GhostWrench/ttrpg9000/img/4ColorDice.png

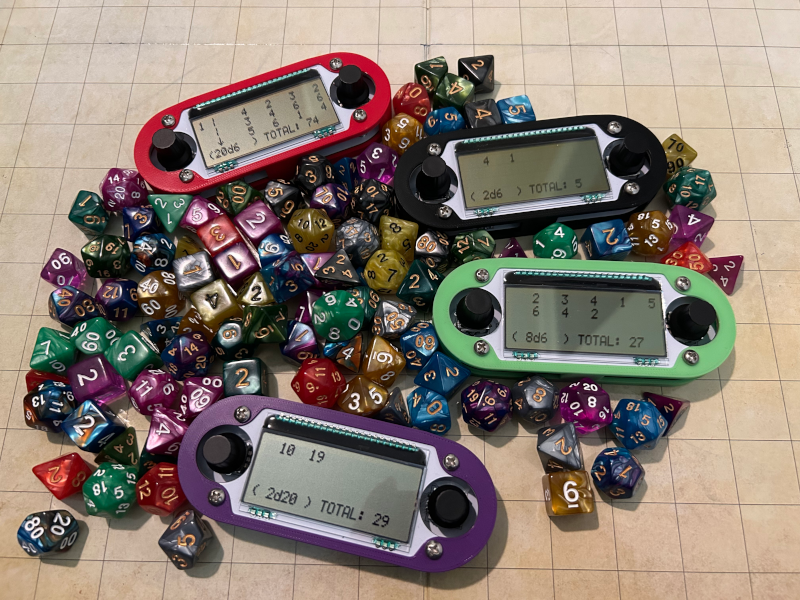
img/4ColorDice.png
