GhostWrench/ttrpg9000/case/InsertSword.FCStd

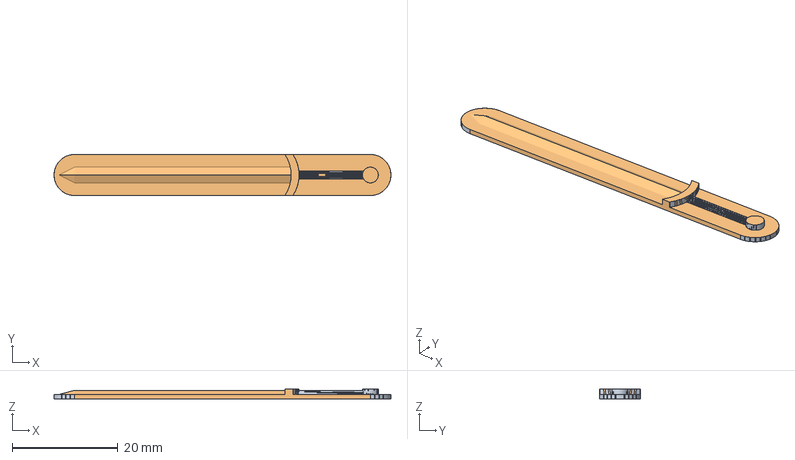
[picture p4: CAD file, 2026-09-27]
case/InsertSword.FCStd
63.8 x 7.80 x 1.80 mm
InsertSword
