GhostWrench/ttrpg9000/case/InsertCircuit.FCStd

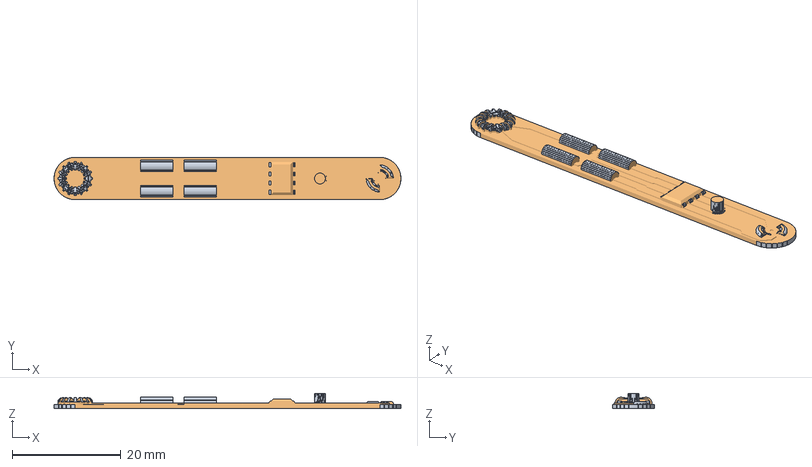
[picture p5: CAD file, 2026-09-27]
case/InsertCircuit.FCStd
63.8 x 7.80 x 2.80 mm
InsertCircuit
