GhostWrench/ttrpg9000/case/InsertRacetrack.FCStd

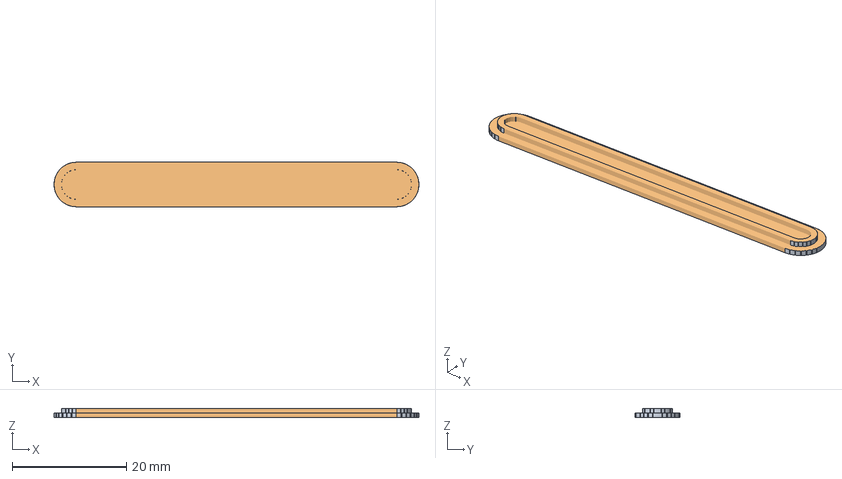
[picture p6: CAD file, 2026-09-27]
case/InsertRacetrack.FCStd
63.8 x 7.80 x 1.60 mm
InsertRacetrack
