GhostWrench/ttrpg9000/case/KnobHexagon.FCStd

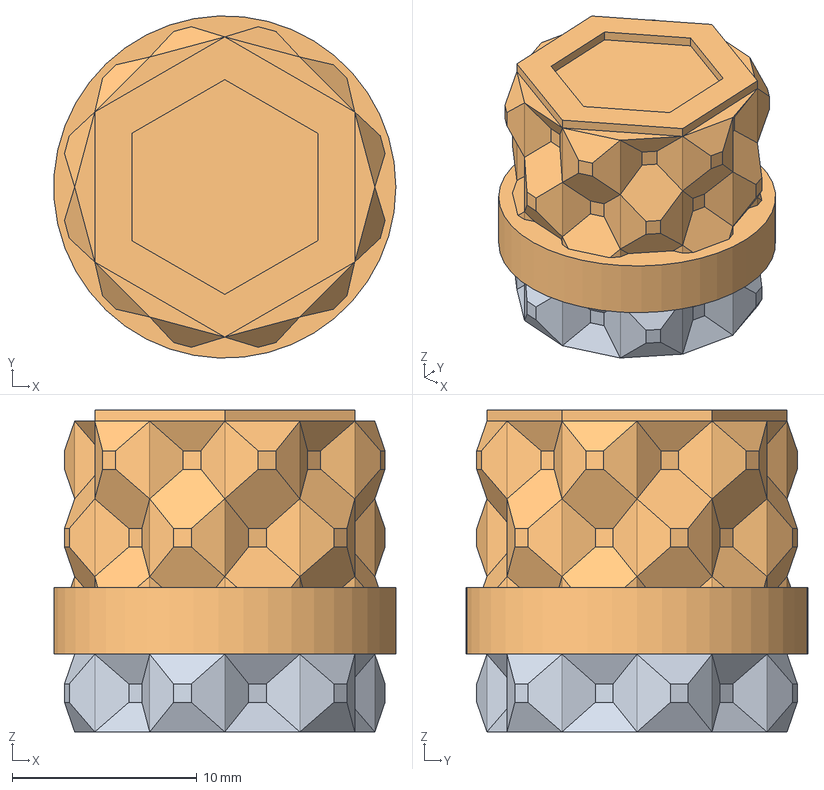
[picture p7: CAD file, 2026-09-27]
case/KnobHexagon.FCStd
18.5 x 18.5 x 17.4 mm
KnobHexagon
