GhostWrench/ttrpg9000/case/CaseMinimal.FCStd

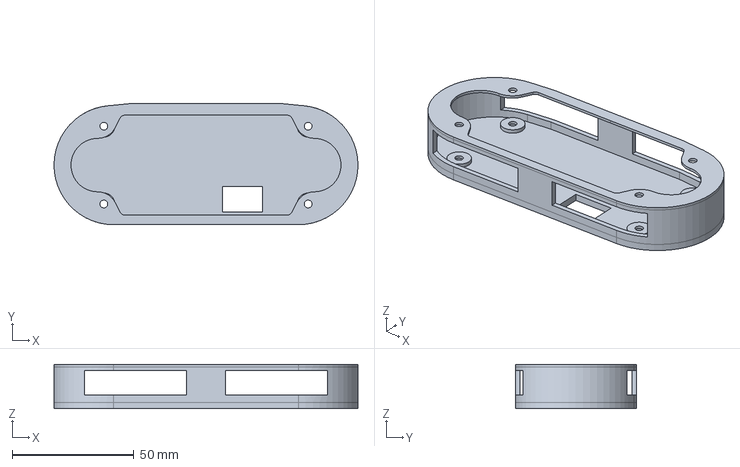
[picture p8: CAD file, 2026-09-27]
case/CaseMinimal.FCStd
125.0 x 49.9 x 18.2 mm
