GhostWrench/ttrpg9000/case/KnobD20.FCStd

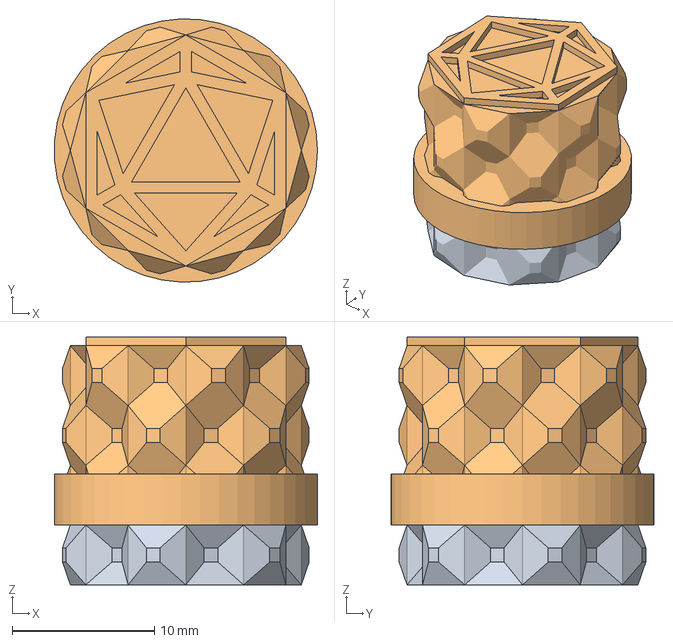
[picture p9: CAD file, 2026-09-27]
case/KnobD20.FCStd
18.5 x 18.5 x 17.4 mm
KnobD20
