GhostWrench/ttrpg9000/case/Stand.FCStd

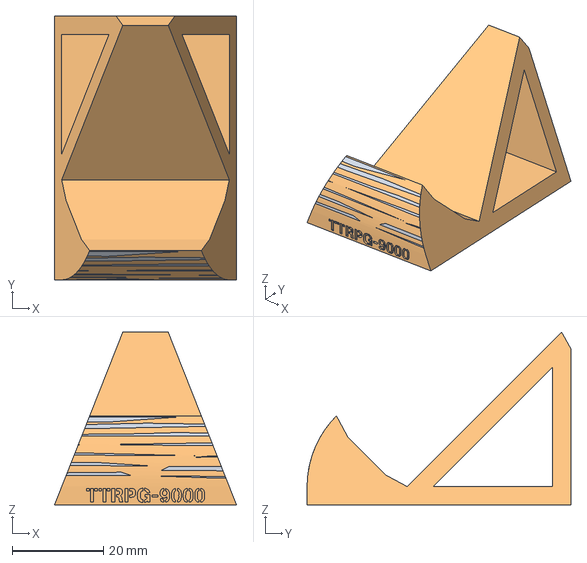
[picture p10: CAD file, 2026-09-27]
case/Stand.FCStd
40.0 x 58.0 x 37.9 mm
Stand
