GhostWrench/ttrpg9000/case/CaseFancy.FCStd

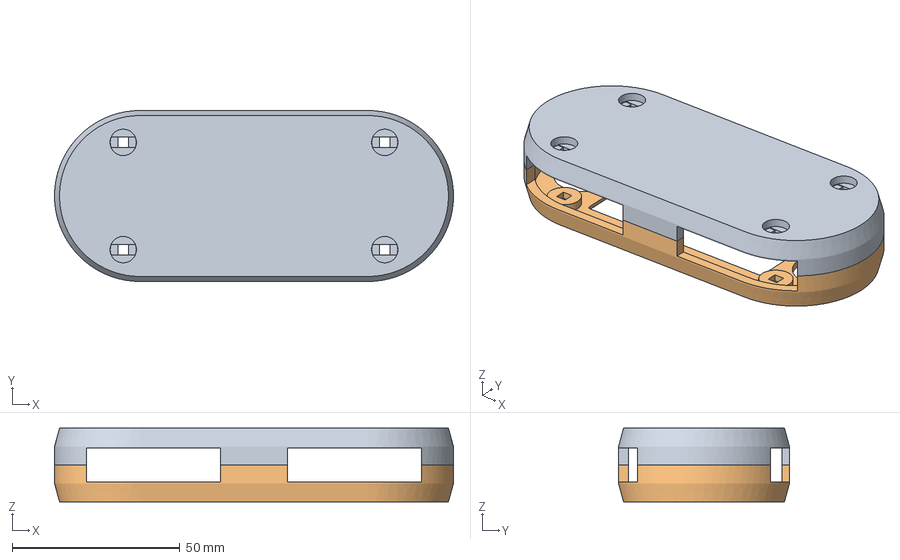
[picture p11: CAD file, 2026-09-27]
case/CaseFancy.FCStd
119.0 x 51.0 x 22.0 mm
CaseBottom
CaseTop
