GhostWrench/ttrpg9000/code/include/ui.h

/**
 * @file ui.h
 * @defgroup ttrpg9000_ui User interface module
 * @brief Home, dice selection and roll result screens.
 *
 * The UI is a small state machine driven by UIInput events which are
 * produced by the GPIO interrupt handlers when the user turns an
 * encoder or presses a button.
 */

#ifndef TTRPG9000_UI_H
#define TTRPG9000_UI_H

/**
 * @ingroup ttrpg9000_ui
 * @brief User input events reported to the UI.
 */
typedef enum __attribute__((packed)) {
    /** Left encoder rotated clockwise. */
    ENL_CW,
    /** Left encoder rotated counter clockwise. */
    ENL_CCW,
    /** Left pushbutton pressed. */
    PBL_PRESS,
    /** Right encoder rotated clockwise. */
    ENR_CW,
    /** Right encoder rotated counter clockwise. */
    ENR_CCW,
    /** Right pushbutton pressed. */
    PBR_PRESS,
} UIInput;

/**
 * @ingroup ttrpg9000_ui
 * @brief Show the home (title) screen.
 *
 * Resets the UI to the home screen and displays the title. The dice
 * selection defaults depend on the active game mode.
 */
void ui_home(void);

/**
 * @ingroup ttrpg9000_ui
 * @brief Handle a user input event.
 *
 * Interprets the input in the context of the currently displayed
 * screen and updates the display and UI state accordingly.
 *
 * @param input The input event to process.
 */
void ui_manager(UIInput input);

#endif // TTRPG9000_UI_H
