GhostWrench/ttrpg9000/(commit log)

2024-04-13 Add initial schematic
    [ttrpg9000.kicad_pcb, ttrpg9000.kicad_sch]
2024-04-13 Add KiCAD .gitignore file
2024-04-13 Second pass of schematic, start layout
    [ttrpg9000.kicad_pcb, ttrpg9000.kicad_sch]
2024-04-13 Clean up board layout
    [2024-04-13T023628.csv, ttrpg9000.kicad_pcb, ttrpg9000.kicad_sch]
2024-04-14 Finalize v0.1 board layout
    [ttrpg9000.kicad_pcb]
2024-04-14 Fix logo silk mask
    [2024-04-12T162524.csv, 2024-04-13T023628.csv, ttrpg9000.kicad_pcb]
2024-04-14 Update gerber output file
    [ttrpg9000.kicad_pcb]
2024-04-16 Move hardware designs to the 'hardware' folder
    [ttrpg9000.kicad_pcb, ttrpg9000.kicad_sch]
2024-04-16 Add RESET pull-up, mounting holes
    [ttrpg9000.kicad_pcb, ttrpg9000.kicad_sch]
2024-04-16 Add programming header to the board
    [ttrpg9000.kicad_pcb, ttrpg9000.kicad_sch]
2024-04-16 Add silkscreen info to board
    [ttrpg9000.kicad_pcb, ttrpg9000.kicad_sch]
2024-04-17 Add mounting holes to the PCB
    [ttrpg9000.kicad_pcb, ttrpg9000.kicad_sch]
2024-04-20 Fix resistor footprints
    [ttrpg9000.kicad_pcb, ttrpg9000.kicad_sch]
2024-04-23 Wire pushbuttons to ground because ATtiny2313 have pull-up pins
    [ttrpg9000.kicad_pcb, ttrpg9000.kicad_sch]
2024-04-23 Start writing the software for the board
2024-04-24 Board initialization code first pass
2024-04-25 Change regulator footprint so that it is easier to solder
    [ttrpg9000.kicad_pcb, ttrpg9000.kicad_sch]
2024-04-25 Move MCU to front of the board
    [ttrpg9000.kicad_pcb]
2024-04-25 Make battery holder smaller and move to the front, plate mounting holes
    [ttrpg9000.kicad_pcb, ttrpg9000.kicad_sch]
2024-04-25 Export v0.2 hardware design
    [ttrpg9000.kicad_pcb]
2024-04-27 Update schematic and layout for SPI connection to LCD screen
    [ttrpg9000.kicad_pcb, ttrpg9000.kicad_sch]
2024-04-27 Fix battery holder placement
    [ttrpg9000.kicad_pcb]
2024-04-27 Add compiling SPI versoin of main
2024-05-03 LCD works with SPI
2024-05-04 Fix interrupts for encoder and pushbutton input
    [main.c]
2024-05-04 Update pushbutton cap values for better debounce
    [ttrpg9000.kicad_pcb, ttrpg9000.kicad_sch]
2024-05-05 Make the board into a board sandwich
    [ttrpg9000.kicad_pcb, ttrpg9000.kicad_sch]
2024-05-05 Not sure what changed
    [ttrpg9000.kicad_pcb]
2024-05-07 Add bigger ribbon cable connectors, status leds
    [ttrpg9000.kicad_pcb, ttrpg9000.kicad_sch]
2024-05-07 Update version indicators
    [ttrpg9000.kicad_pcb, ttrpg9000.kicad_sch]
2024-05-07 Fix hole size, make LEDs more central
    [ttrpg9000.kicad_pcb, ttrpg9000.kicad_sch]
2024-05-07 Final touch-ups
    [ttrpg9000.kicad_pcb, ttrpg9000.kicad_sch]
2024-05-07 Add V-Score back into board design
    [ttrpg9000.kicad_pcb]
2024-05-16 Widen footprint, modify layout
    [ttrpg9000.kicad_pcb, ttrpg9000.kicad_sch]
2024-05-16 Make a bigger ground pad for the voltage regulator
    [ttrpg9000.kicad_pcb, ttrpg9000.kicad_sch]
2024-05-16 Update fabrication output location
    [ttrpg9000.kicad_pcb]
2024-05-19 Get encoders working
2024-05-19 Replace fancy ribbon cable connectors with soldered ribbon cable
    [ttrpg9000.kicad_pcb, ttrpg9000.kicad_sch]
2024-05-20 Add basic outline for UI, not currently working right
2024-05-20 Fix screen navigation issue
    [lcd.c, ui.c]
2024-05-20 Fix dice selection and roll info
    [ui.c]
2024-05-20 Widen mounting holes, move LEDs to more visible location
    [ttrpg9000.kicad_pcb, ttrpg9000.kicad_sch]
2024-05-23 Add hookups for LCD LEDs, tweak board arrangement
    [ttrpg9000.kicad_pcb, ttrpg9000.kicad_sch]
2024-05-23 Update hardware version to v1.0
    [ttrpg9000.kicad_pcb, ttrpg9000.kicad_sch]
2024-05-24 Move LCD screen caps away from battery housing
    [ttrpg9000.kicad_pcb]
2024-05-24 Fix LCD LED wiring
    [ttrpg9000.kicad_pcb, ttrpg9000.kicad_sch]
2024-06-01 Finalize v1.0 board layout
    [ttrpg9000.kicad_pcb, ttrpg9000.kicad_sch]
2024-06-25 Add FreeCAD model of the case
    [case.FCStd]
2024-06-25 Move the PCB files to 'pcb' folder
    [ttrpg9000.kicad_pcb, ttrpg9000.kicad_sch]
2024-06-26 Add case STL files for manufacture
    [Bottom.stl, BottomHeader.stl, Top.stl]
2024-08-26 Slight update to case design
    [Bottom.stl, BottomHeader.stl, Top.stl, case.FCStd]
2024-09-12 Add a new, beefier case for resin casting
    [caseB.FCStd]
2024-09-14 Update caseB
    [caseB.FCStd]
2024-09-18 Refine beefy case a bit
    [caseB.FCStd, knob.FCStd]
2024-09-18 Add sword design to caseB
    [caseB.FCStd]
2024-09-19 Update caseB slightly
    [caseB.FCStd]
2024-10-05 Another case modification
    [caseB.FCStd, knob.FCStd, sword.FCStd]
2024-11-18 Move bottom FPC connector away from edge
    [ttrpg9000.kicad_pcb]
2024-11-20 Remove LED circuits and 3.3V regulator
    [ttrpg9000.kicad_pcb, ttrpg9000.kicad_sch]
2024-11-20 Replace battery holder with single cell available from JLCPCB
    [ttrpg9000.kicad_pcb, ttrpg9000.kicad_sch]
2024-11-21 Reduce overall size of the PCB
    [ttrpg9000.kicad_pcb]
2024-11-21 Move mounting holes slightly closer
    [ttrpg9000.kicad_pcb]
2024-12-07 Change battery mounting hole radius
    [ttrpg9000.kicad_pcb, ttrpg9000.kicad_sch]
2025-02-22 Fix CaseB Model for FreeCAD 1.0.0 update
    [caseB.FCStd]
2025-02-22 Re-dimension CaseB for new electronics
    [caseB.FCStd]
2025-02-22 Fix the knob model for FreeCAD version 1.0.0
    [knob.FCStd]
2025-03-16 Fix caseB screen orientation
    [caseB.FCStd]
2025-05-02 Fix the minimal case model
    [case.FCStd]
2025-08-12 Fix the knob model
    [knob.FCStd]
2025-08-15 Remove code for driving the LEDs, which no longer exist
    [gpio.c, ui.c]
2025-11-11 Add new case design
    [CyberInset.FCStd, Knob2.FCStd, SwordInset.FCStd, caseB.FCStd]
2025-11-23 Finishing touches on the new case
    [CyberInset.FCStd, Knob2.FCStd, caseB.FCStd]
2025-11-30 Fix CPU clock warning
    [main.c]
2025-12-08 Add new cyber insert design
    [CyberInset2.FCStd]
2026-01-30 Reduce thickness of knob base for better fit
    [Knob2.FCStd, knob.FCStd]
2026-04-12 Clarify programming voltage in the README
2026-09-26 Remove LED toggle
2026-09-27 Add design for display stand
    [Stand.FCStd]
2026-09-27 Better organize the case design files
    [CaseFancy.FCStd, CaseMinimal.FCStd, CyberInset.FCStd, CyberInset2.FCStd, InsertCircuit.FCStd, InsertRacetrack.FCStd, InsertSword.FCStd, Knob2.FCStd]
